zacseriano/higrolar/docs/apendices/D-declaracao-de-ia.tex

\chapter{Declaração de uso de inteligência artificial generativa}\label{ap:ia}
A equipe declara o uso de IA generativa como ferramenta auxiliar na redação desta versão do relatório, revisão de código e planejamento de análises, mantendo o dever de auditar resultados antes da submissão. A ferramenta não foi fonte de leituras do sensor: os valores quantitativos apresentados derivam dos registros CSV da equipe e foram reprocessados por scripts.
\begin{table}[H]\centering\caption{Transparência de utilização de IA na AP2}\label{tab:ia}\footnotesize
\begin{tabular}{@{}L{3.2cm}L{2.7cm}L{4.6cm}L{4.3cm}@{}}\toprule
\textbf{Etapa}&\textbf{Ferramenta}&\textbf{Atividade}&\textbf{Verificação exigida da equipe}\\\midrule
Firmware/integração&ChatGPT&Discussão de MQTT, reinício e identificação de mensagens&Compilação, observação no ESP32 e MQTTX\\
Gravador/analisador&ChatGPT&Revisão e adaptação dos scripts ao EMQX/TLS&Execução local sobre mensagens reais, conferência do CSV\\
Relatório e gráficos&ChatGPT&Organização de capítulos e geração preliminar dos textos/figuras&Releitura por todos, validação dos valores e citações\\
Revisão do relatório&Claude (Anthropic)&Conferência do relatório contra as instruções da AP2, \emph{script} \texttt{limpar.py} e tabelas do Capítulo~\ref{cap:conectividade} calculadas do CSV&Números reconferidos contra \texttt{mensagens.csv} e a saída do \texttt{qualidade.py}\\
Coleta e eventos&Sem IA no sensor&Leituras e ações humanas efetivamente observadas&Logs, CSV e diário de campo\\
\bottomrule\end{tabular}\fonte{Elaborada pela equipe.}\end{table}
\noindent\textbf{Declaração.} A equipe declara que o conteúdo deste relatório e do código a ele associado foi revisado e é compreendido por todos os integrantes, e que todo uso de ferramentas de inteligência artificial generativa está registrado na tabela acima.
\vspace{0.6cm}
\imprimirTabelaIntegrantes
\vspace{0.6cm}
\noindent\localEntrega, \dataEntrega.
