zacseriano/higrolar/docs/conteudo/00-siglas.tex

\begin{siglas}
\item[AP1/AP2] Primeira/segunda avaliação parcial
\item[BLE] Bluetooth Low Energy
\item[CSV] Comma-Separated Values
\item[DHCP] Dynamic Host Configuration Protocol
\item[GPIO] General-Purpose Input/Output
\item[I\textsuperscript{2}C] Inter-Integrated Circuit
\item[IoT] Internet of Things
\item[LWT] Last Will and Testament
\item[MQTT] Message Queuing Telemetry Transport
\item[NTP] Network Time Protocol
\item[NVS] Non-Volatile Storage
\item[QoS] Quality of Service
\item[TLS] Transport Layer Security
\item[UR] Umidade relativa do ar
\end{siglas}
