zacseriano/higrolar/docs/conteudo/06-dados-e-modelo.tex

% Capitulo reservado exclusivamente ao Ciclo de Projeto 3.
