zacseriano/higrolar/docs/evidencias/prints/Captura de tela 2026-10-23 142603.png

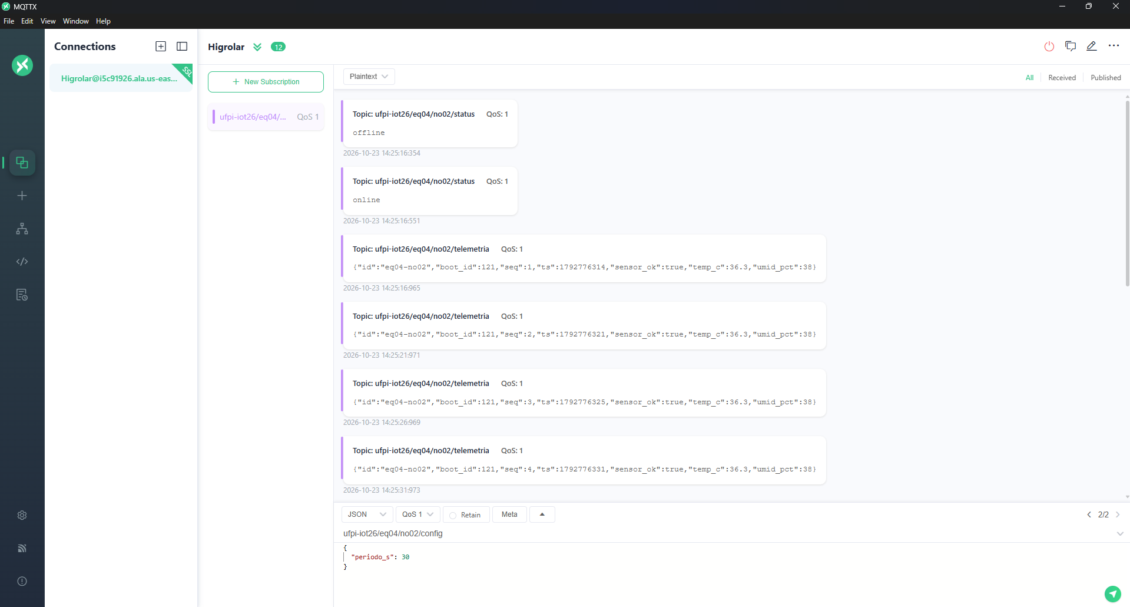
docs/evidencias/prints/Captura de tela 2026-10-23 142603.png
