zacseriano/higrolar/docs/evidencias/prints/Captura de tela 2026-10-23 143917.png

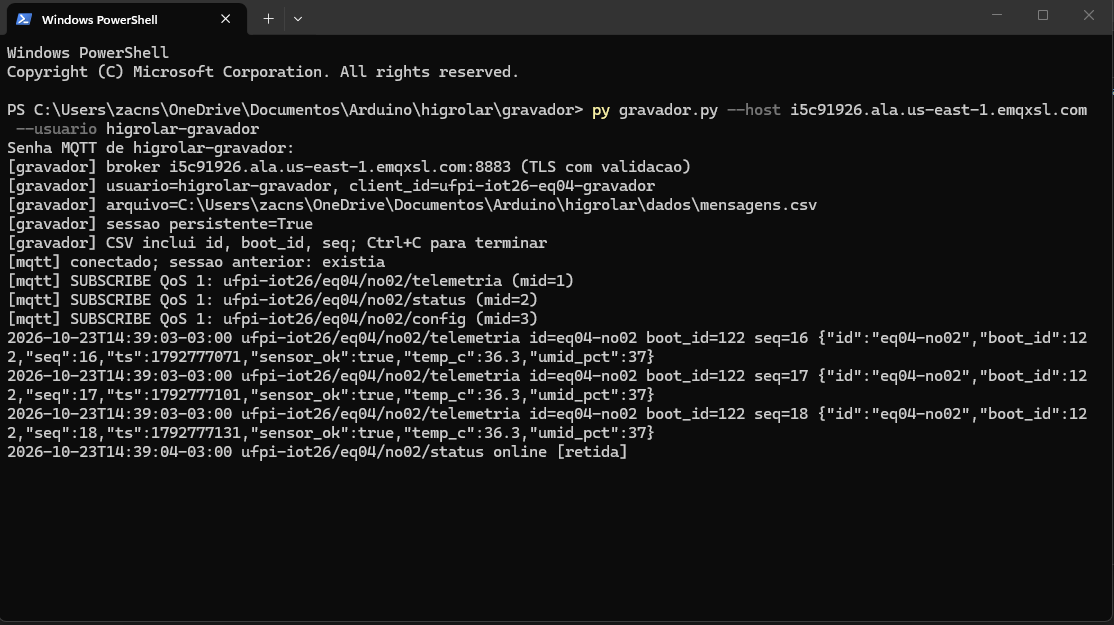
docs/evidencias/prints/Captura de tela 2026-10-23 143917.png
