zacseriano/higrolar/docs/evidencias/prints/Captura de tela 2026-10-23 144653.png

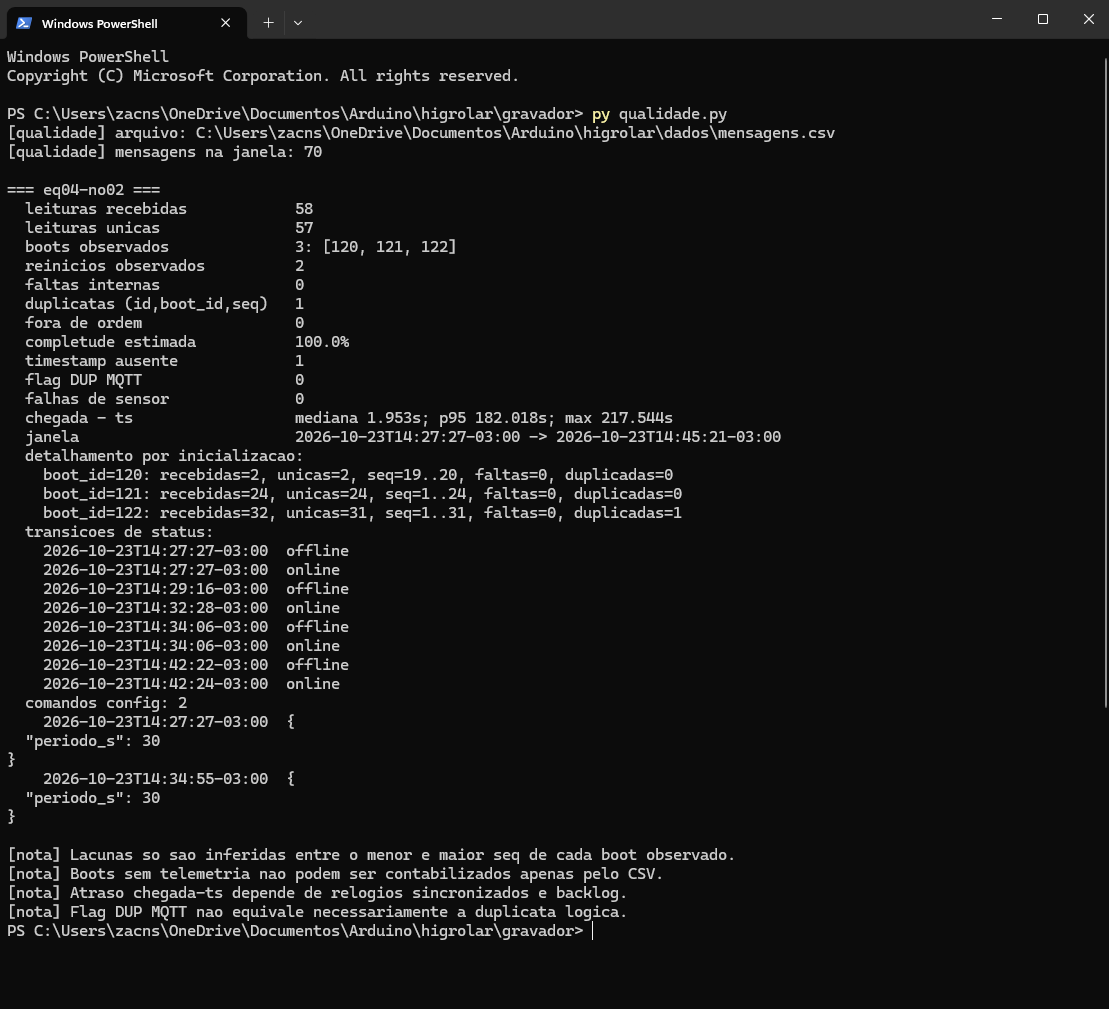
docs/evidencias/prints/Captura de tela 2026-10-23 144653.png
