zacseriano/higrolar/docs/evidencias/1 - Serial Monitor - Teste de Envio para EMQX.txt

[sensor] T=28.5 C | UR=41 %
[sensor] T=28.5 C | UR=41 %
[sensor] T=28.5 C | UR=41 %
[sensor] T=28.5 C | UR=41 %
[sensor] T=28.5 C | UR=41 %
[sensor] T=28.5 C | UR=41 %
[sensor] T=28.5 C | UR=41 %
[sensor] T=28.5 C | UR=41 %
[sensor] T=28.5 C | UR=41 %
[sensor] T=28.5 C | UR=41 %
[sensor] T=28.5 C | UR=41 %
[sensor] T=28.5 C | UR=41 %
[sensor] T=28.5 C | UR=41 %
[sensor] T=28.5 C | UR=41 %
[sensor] T=28.5 C | UR=41 %
[sensor] T=28.5 C | UR=41 %
[sensor] T=28.5 C | UR=41 %
[sensor] T=28.5 C | UR=41 %
[sensor] T=28.5 C | UR=41 %
[sensor] T=28.5 C | UR=41 %
[sensor] T=28.5 C | UR=41 %
[sensor] T=28.5 C | UR=41 %
[sensor] T=28.5 C | UR=41 %
[sensor] T=28.5 C | UR=41 %
[sensor] T=28.5 C | UR=41 %
[sensor] T=28.5 C | UR=41 %
[sensor] T=28.5 C | UR=41 %
[sensor] T=28.5 C | UR=41 %
[sensor] T=28.5 C | UR=41 %
[sensor] T=28.5 C | UR=41 %
[sensor] T=28.5 C | UR=41 %
[sensor] T=28.5 C | UR=41 %
[sensor] T=28.5 C | UR=41 %
[sensor] T=28.5 C | UR=41 %
[sensor] T=28.5 C | UR=41 %
[sensor] T=28.5 C | UR=41 %
[sensor] T=28.5 C | UR=41 %
[sensor] T=28.5 C | UR=41 %
[sensor] T=28.5 C | UR=41 %
[sensor] T=28.5 C | UR=41 %
[sensor] T=28.5 C | UR=41 %
[sensor] T=28.5 C | UR=41 %
[sensor] T=28.5 C | UR=41 %
[sensor] T=28.5 C | UR=41 %
[sensor] T=28.5 C | UR=41 %
[sensor] T=28.5 C | UR=41 %
[sensor] T=28.5 C | UR=41 %
[sensor] T=28.5 C | UR=41 %
[sensor] T=28.5 C | UR=41 %
[sensor] T=28.5 C | UR=41 %
[sensor] T=28.5 C | UR=41 %
[sensor] T=28.5 C | UR=41 %
[sensor] T=28.5 C | UR=41 %
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
[sensor] T=28.5 C | UR=41 %
[sensor] T=28.5 C | UR=41 %
[sensor] T=28.5 C | UR=41 %
[sensor] T=28.5 C | UR=41 %
[sensor] T=28.5 C | UR=41 %
[sensor] T=28.5 C | UR=41 %
[sensor] T=28.5 C | UR=41 %
[sensor] T=28.5 C | UR=41 %
[sensor] T=28.5 C | UR=41 %
[sensor] T=28.5 C | UR=41 %
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
