zacseriano/higrolar/docs/evidencias/qualidade_teste_reinicio.txt

Windows PowerShell
Copyright (C) Microsoft Corporation. All rights reserved.

PS C:\Users\zacns\OneDrive\Documentos\Arduino\higrolar\gravador> py qualidade.py
[qualidade] arquivo: C:\Users\zacns\OneDrive\Documentos\Arduino\higrolar\dados\mensagens.csv
[qualidade] mensagens na janela: 70

=== eq04-no02 ===
  leituras recebidas            58
  leituras unicas               57
  boots observados              3: [120, 121, 122]
  reinicios observados          2
  faltas internas               0
  duplicatas (id,boot_id,seq)   1
  fora de ordem                 0
  completude estimada           100.0%
  timestamp ausente             1
  flag DUP MQTT                 0
  falhas de sensor              0
  chegada - ts                  mediana 1.953s; p95 182.018s; max 217.544s
  janela                        2026-10-23T14:27:27-03:00 -> 2026-10-23T14:45:21-03:00
  detalhamento por inicializacao:
    boot_id=120: recebidas=2, unicas=2, seq=19..20, faltas=0, duplicadas=0
    boot_id=121: recebidas=24, unicas=24, seq=1..24, faltas=0, duplicadas=0
    boot_id=122: recebidas=32, unicas=31, seq=1..31, faltas=0, duplicadas=1
  transicoes de status:
    2026-10-23T14:27:27-03:00  offline
    2026-10-23T14:27:27-03:00  online
    2026-10-23T14:29:16-03:00  offline
    2026-10-23T14:32:28-03:00  online
    2026-10-23T14:34:06-03:00  offline
    2026-10-23T14:34:06-03:00  online
    2026-10-23T14:42:22-03:00  offline
    2026-10-23T14:42:24-03:00  online
  comandos config: 2
    2026-10-23T14:27:27-03:00  {
  "periodo_s": 30
}
    2026-10-23T14:34:55-03:00  {
  "periodo_s": 30
}

[nota] Lacunas so sao inferidas entre o menor e maior seq de cada boot observado.
[nota] Boots sem telemetria nao podem ser contabilizados apenas pelo CSV.
[nota] Atraso chegada-ts depende de relogios sincronizados e backlog.
[nota] Flag DUP MQTT nao equivale necessariamente a duplicata logica.
