zacseriano/higrolar/docs/figuras/ensaio_simultaneo_final.pdf

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

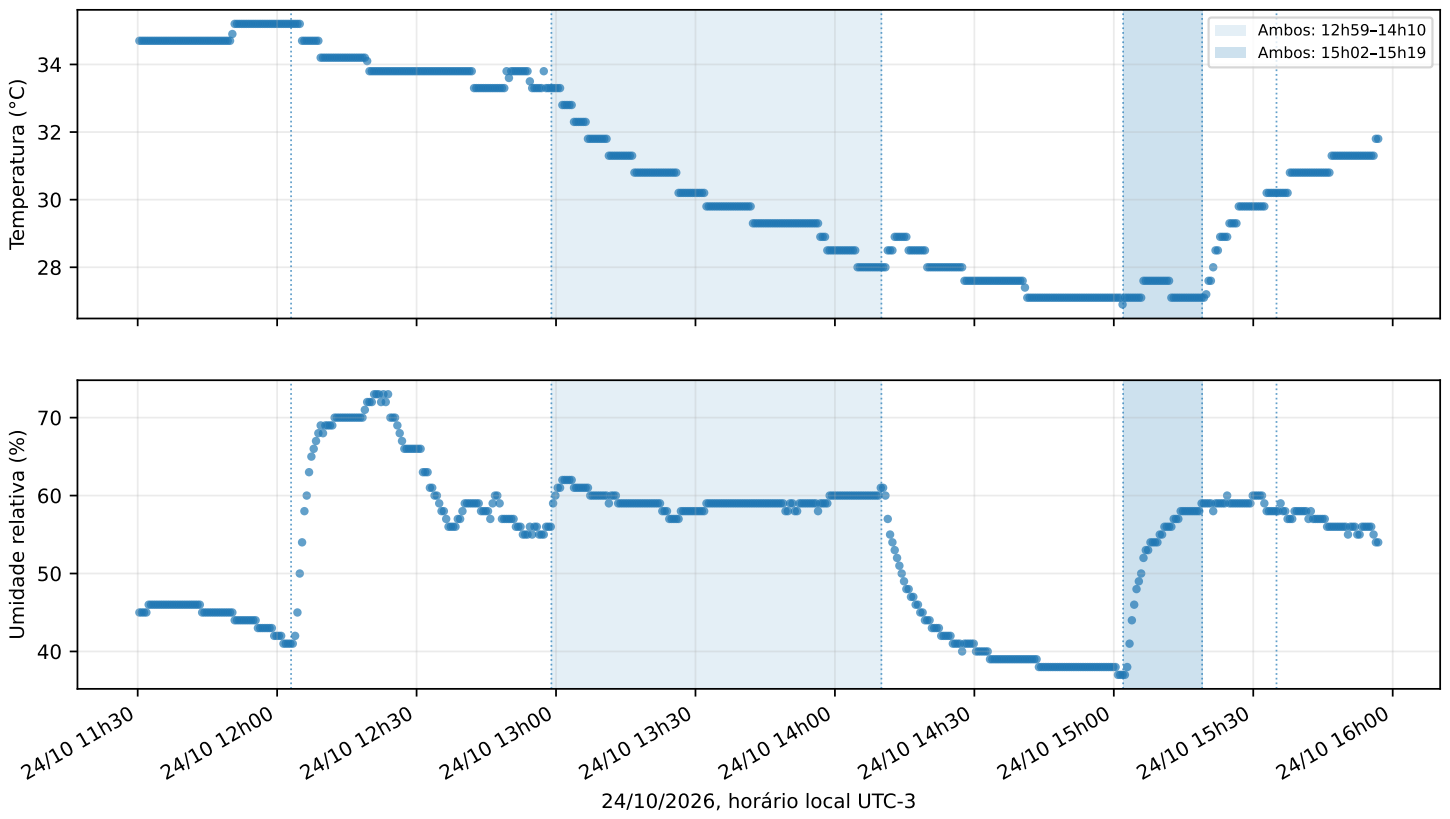
[picture p27: page 1]
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
