zacseriano/higrolar/(commit log)

2026-10-23 integracao com mqtt
    [mensagens.csv]
2026-10-24 Finalização do relatório
    [mensagens.csv]
2026-10-24 Completa capítulo 5, papéis da AP2 e script de limpeza dos dados
    [telemetria_limpa.csv]
2026-10-24 Remove integrante que saiu da disciplina
2026-10-24 Atribui plano de testes e checklist e aponta para a tag ap2-final
